marcorispoli/PCB310/DATASHEETS/TCST5250_LAYOUT.png

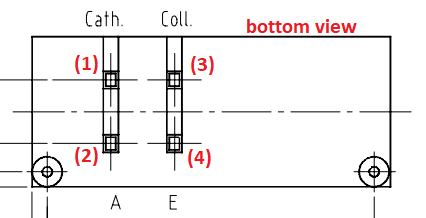
DATASHEETS/TCST5250_LAYOUT.png
