marcorispoli/PCB310/ESECUTIVI/LP22-310-0.xlsx

LISTA PARTI SCHEDA 22-310-0 |  |  | DATA 13/12/2023
Pos. | Qtà | Rif | Descrizione | Value | PN Costruttore | PN Fornitore | Costruttore | Package | Note
1 | 1 | C1 | Cond.Ceramico Multilayer 0805 50V X7R | 330nF |  | MULTICOMP | VARI | SMD0805 | MLCC, X7R, 100V 0805
2 | 9 | C2,C3,C4,C6,C8,C9,C11,C15,C16 | MLCC - SMD/SMT 50V 0.1uF X7R 0603 10% | 100nF | 06035C104KAT2A | M:80-C0603C104K5R | VARI | SMD0603 | MLCC, X7R, 50V 0603
3 | 3 | C5,C7,C10 | MLCC - SMD/SMT 50V 10nF X7R 0603 10% | 10nF |  | MULTICOMP | VARI | SMD0603 | MLCC, X7R, 50V 0603
4 | 2 | C12,C13 | MLCC - SMD/SMT 10V .56uF X7R 0805 5% Tol | 560nF |  | MULTICOMP | VARI | SMD0805 | MLCC, X7R, 100V 0805
5 | 1 | DS1 | Diodo Schottky | PMEG050V150EPE |  | F-4048445 | Nexperia | SOT-1289B-3 | 50 V, 21A, 300 pk
6 | 1 | J1 | 3 pin Verticale, p 2.54 JST | B3B-XH-AM |  | D: 455-B3B-XH-AM-ND | JST
7 | 1 | J2 | CONN.HEADER 2X3 DRITTO P2 | NANO-FIT 105312-1106 | 105312-1106 | M: 538-105312-1106 | MOLEX |  | SERIE NANO-FIT
8 | 1 | J3 | CONN.HEADER 2X5 DRITTO P2 | NANO-FIT 105310-2210 | 105310-2210 | M: 538-105310-2210 | MOLEX | THT | SERIE NANO-FIT
9 | 1 | J4 | CONN.HEADER 2X1 DRITTO P2 | NANO-FIT 105311-1102 | 105311-1102 | M: 538-105311-1102 | MOLEX |  | SERIE NANO-FIT
10 | 3 | OC1,OC2,OC3 | Foto interruttore trasmissivo | TCST5250 |  | D: 751-1039-5-ND | VISHAY
11 | 1 | PTC1 | Ripristinabile, 0.75A, Ttr=1s, Itr=1.5A | 750mA | 1210L075/24PR | M: 576-1210L075/24PR | LittleFuse | SMD050F-2.
12 | 5 | Q1,Q3,Q4,Q5,Q6 | MOSFET CANALE N | 2N7002L | 2N7002L | M: 512-2N7002L | ON | SOT23 | 60V VDS, 115mA, Vth=1.8
13 | 1 | Q2 | MOSFET CANALE N 6A, 60V | SSM3K341R,LF |  | M-757-SSM3K341RLF | Toshiba | SOT-23F
14 | 12 | R1,R2,R3,R4,R5,R6,R20,R23,R24,R25,R26,R27 | Resistore thick film 100mW 1% 0603 | 10K |  | MULTICOMP | VARI | SMD0603 | SMD 0603 1/10W, 1%
15 | 3 | R7,R8,R9 | Resistore thick film 100mW 1% 0603 | 4K7 |  | MULTICOMP | VARI | SMD0603 | SMD 0603 1/10W, 1%
16 | 3 | R10,R13,R16 | Resistore thick film 250mW 1% 1206 | 442R |  | MULTICOMP | VARI | SMD1206 | SMD 1206 1/4W 1%
17 | 3 | R11,R14,R18 | Resistore thick film 100mW 1% 0603 | 22K |  | MULTICOMP | VARI | SMD0603 | SMD 0603 1/10W, 1%
18 | 3 | R12,R15,R19 | Resistore thick film 100mW 1% 0603 | 3K3 |  | MULTICOMP | VARI | SMD0603 | SMD 0603 1/10W, 1%
19 | 1 | R17 | Resistore thick film 100mW 1% 0603 | 1K7 |  | MULTICOMP | VARI | SMD0603 | SMD 0603 1/10W, 1%
20 | 2 | R21,R22 | Resistore thick film 100mW 1% 0603 | 120K |  | MULTICOMP | VARI | SMD0603
21 | 15 | TP1,TP2,TP3,TP4,TP5,TP6,TP7,TP8,TP9,TP10,TP11,TP12,TP13,TP14,TP15 | Piazzola Through Hole | Piazzola su PCB |  |  |  |  | Foro 1mm
22 | 1 | U1 | Regolatore 5V lineare | LM78M05CDTX/NOPB |  | D: LM78M05CDTX/NOPBDKR-ND | TI | TO-252-3 | Regolatore 5V lineare
23 | 3 | U2,U3,U5 | COMPARATOR WITH hysteresis | TLV7031QDBVRQ1 |  | D: 296-TLV7031QDBVRQ1DKR-ND | TI | SOT23-5
24 | 1 | U4 | Fixed Reference | LM4041CYM3-1.2-TR |  | D: 576-2571-6-ND | MICROCHIP | SOT-23 | 1.225 0.5%
25 | 1 | U6 | INTEGRATO MULTIVIBRATORE MONOSTABILE | HEF4538BT |  | D: 1727-6419-6-ND | NEXPERIA | SOIC-16
26 | 1 | U8 | CIRCUITO INTEGRATO | XC7SH08GW,125 | XC7SH08GW,125 | D: 1727-7093-6-ND | NEXPERIA
27 | 1 | U9 | Single Flip Flop | SN74LVC1G175DCKT |  | D: 296-32299-6-ND | TI | SC70-6 | Single Flip Flop
28 | 1 | U10 | 5V ECONORESET | DS1233DZ-10+ | DS1233DZ-10+ | D: DS1233DZ-10+-ND | MAXIM | SOT223 | SOT223-4
