marcorispoli/PCB310/(list of files, cad)

Other CAD files:
ESECUTIVI/PF22-310-0.dwg
LAYOUT/22-310-0.dwg
ESECUTIVI/22-310-0.dwg
ESECUTIVI/PM22-310-0.dwg
