marcorispoli/PCB310/ORCAD/SE22-310-0.pdf

0

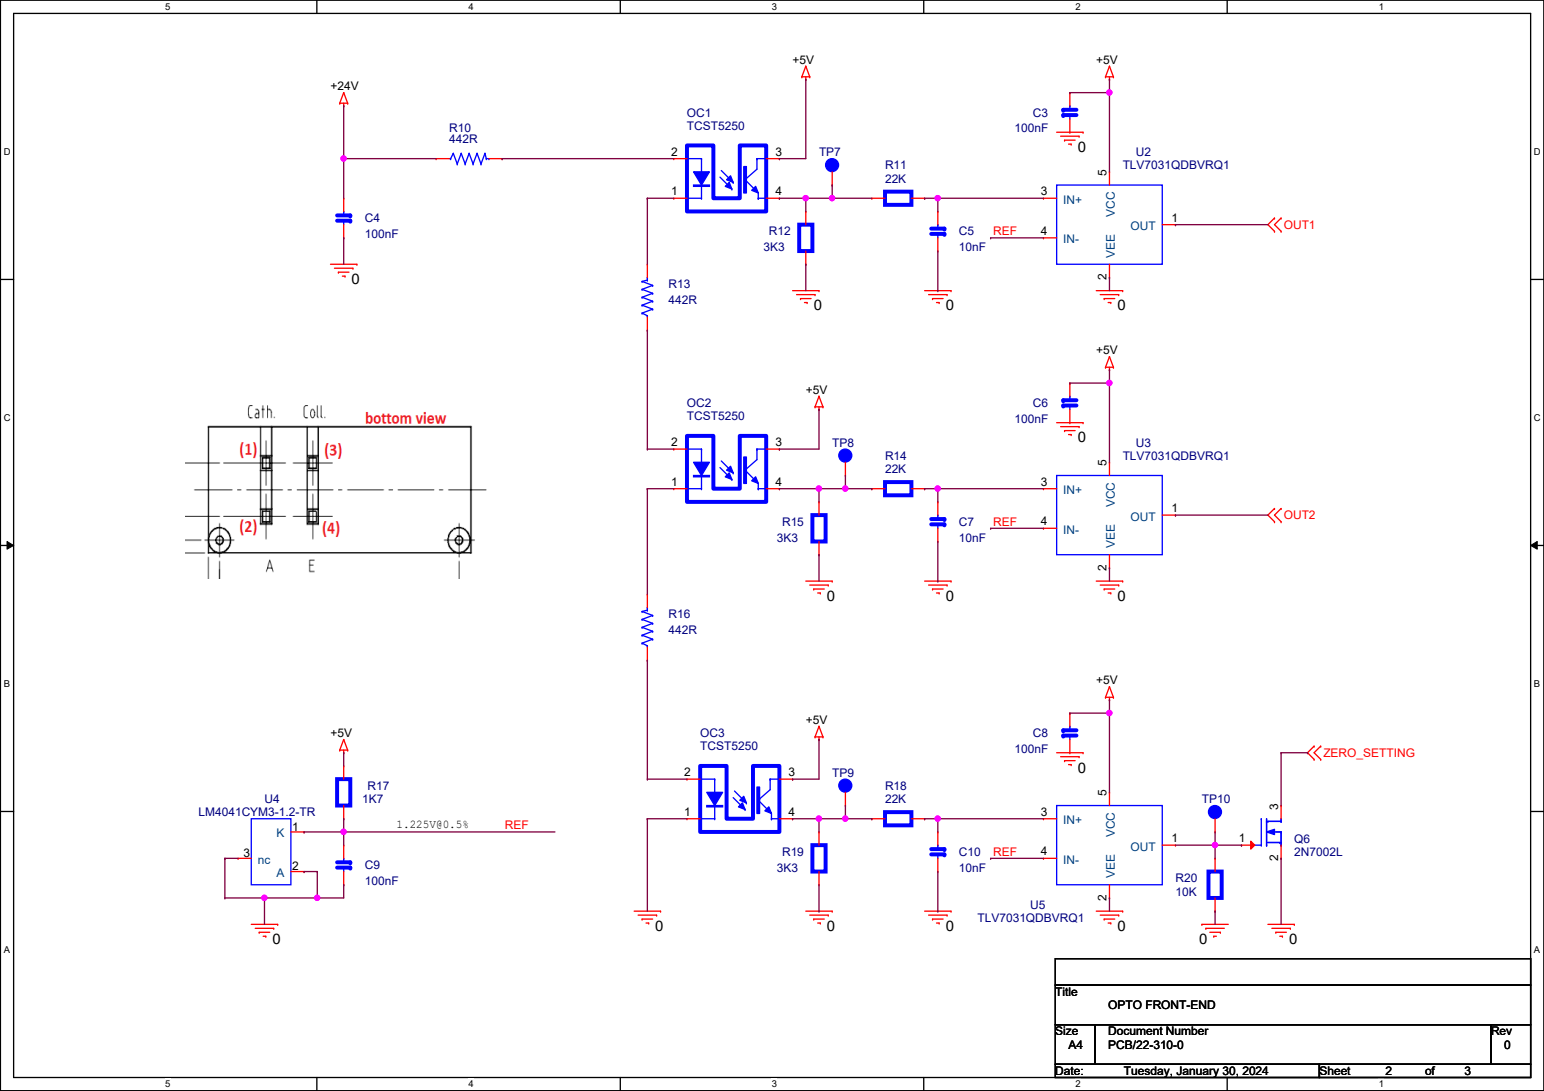
[picture p2: page 1]
