marcorispoli/PCB310/ESECUTIVI/PF22-310-0.pdf

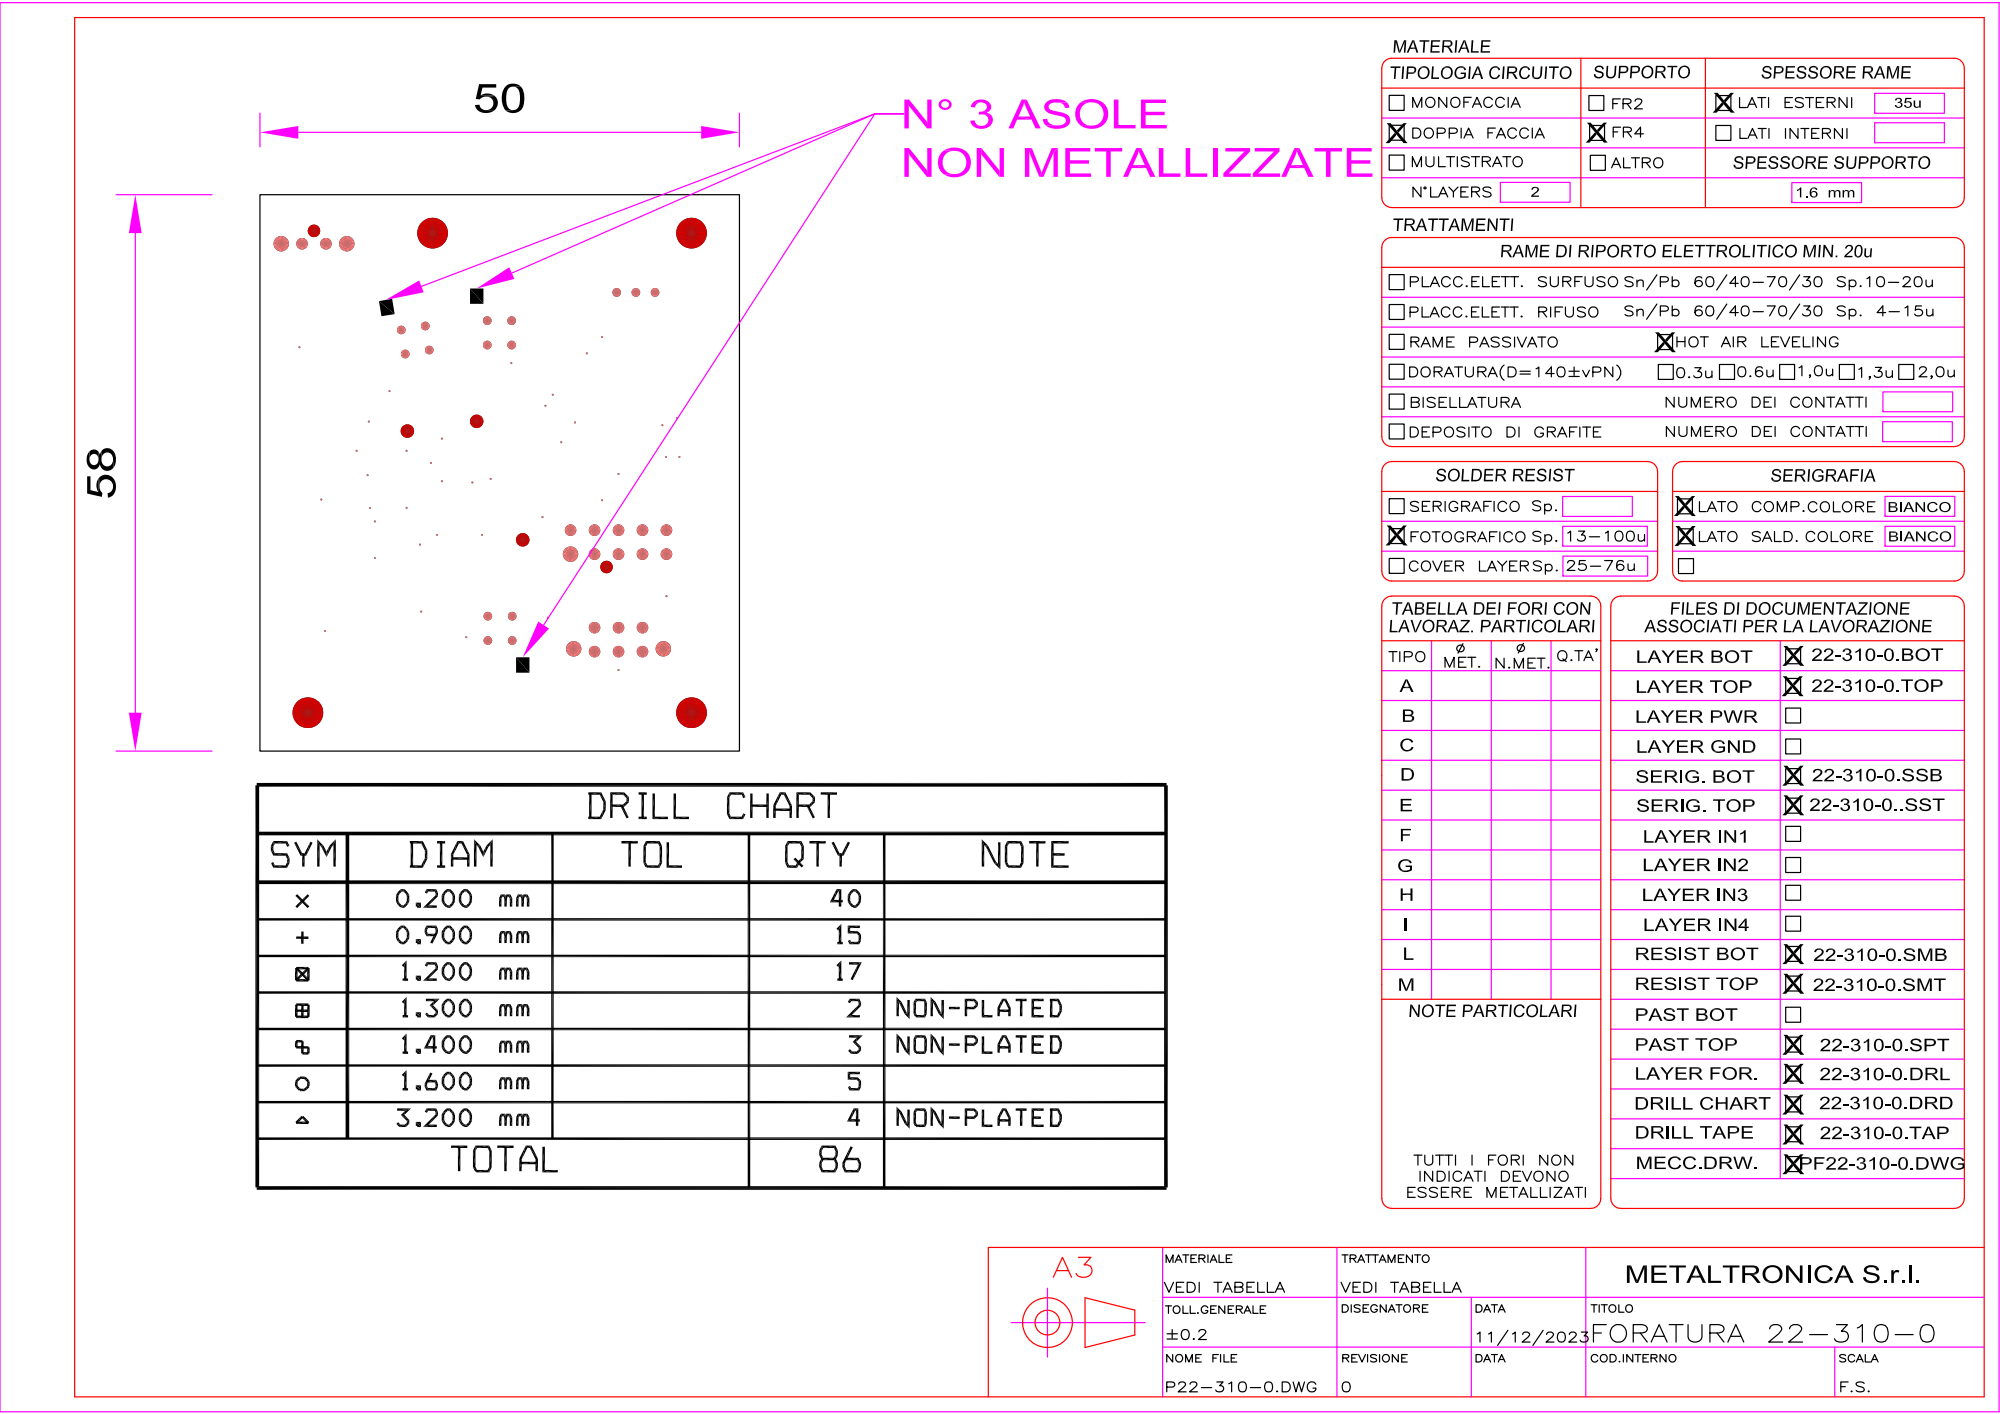
[picture p3: page 1]
