marcorispoli/PCB310/ESECUTIVI/PM22-310-0.pdf

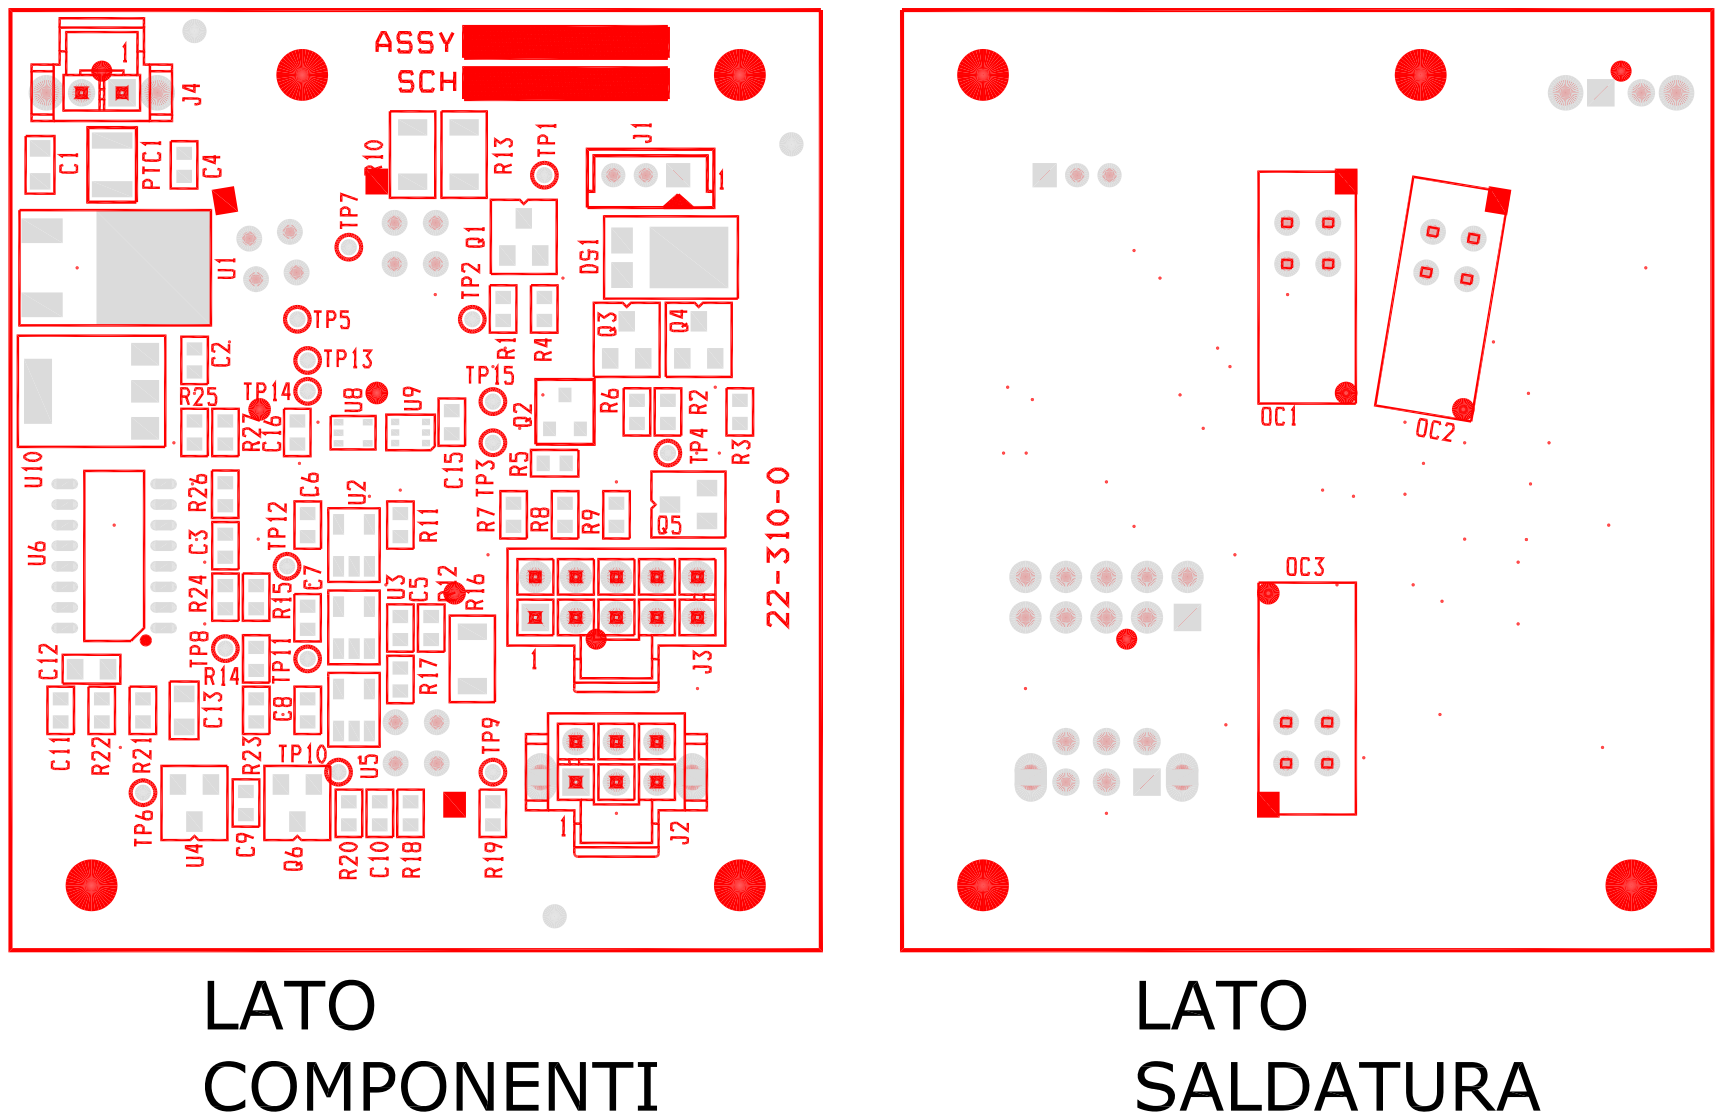
[picture p4: page 1]
