marcorispoli/PCB310/(list of files, drawings)

Other design files:
ORCAD/22-310-0.DSN
ORCAD/22-310-0.opj
