marcorispoli/PCB310/(commit log)

2024-01-08 Scheda già sviluppata
    [22-310-0.DSN, 22-310-0.dwg, 22-310-0.opj, CalcoliVelocità.xlsx, LP22-310-0.xlsx, PF22-310-0.dwg, PM22-310-0.dwg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]
2024-01-30 Aggiornato schematico e lista parti per sostituire C9 con 100nF Con 10nF la tensione di reference potrebbe essere instabile
    [22-310-0.DSN, 22-310-0.opj, LP22-310-0.xlsx]
